gohai/dsbrut/libdsbrut/doc/dsbrut_midi.jpg

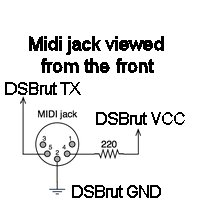
libdsbrut/doc/dsbrut_midi.jpg
