gohai/dsbrut/pcb/ds_bluetooth_v2.png

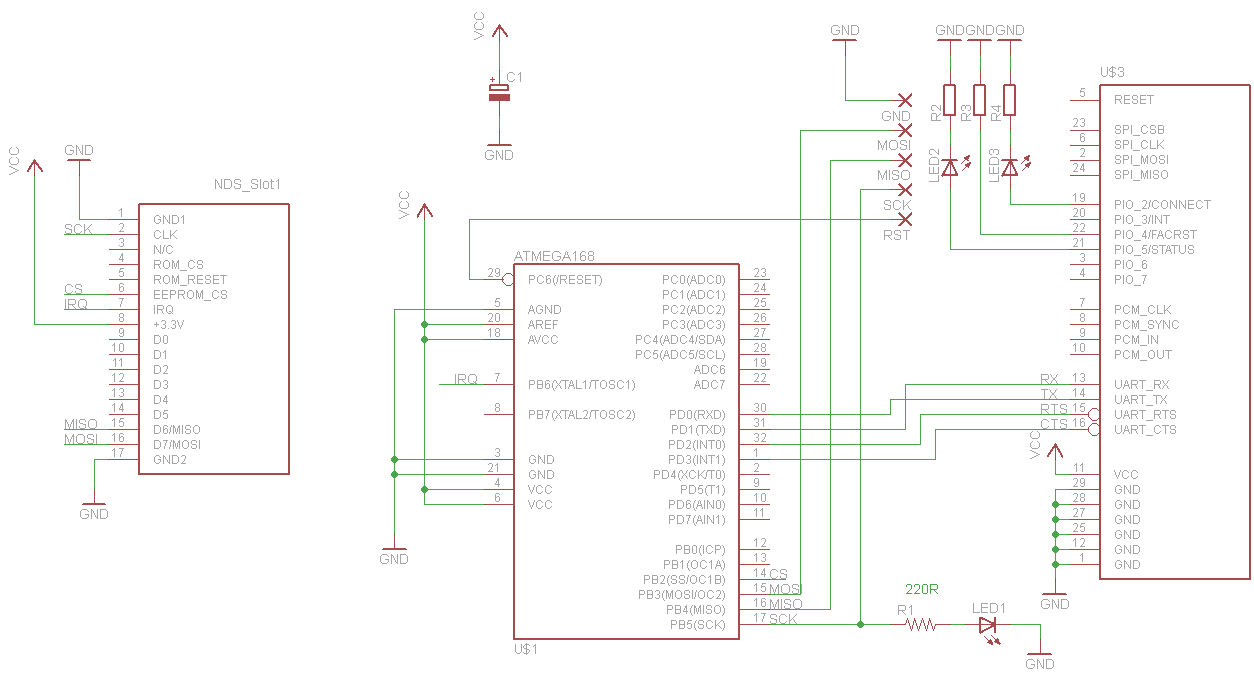
pcb/ds_bluetooth_v2.png
