gohai/dsbrut/pcb/dsbrut2.brd

## EAGLE design pcb/dsbrut2.brd (2014-06-26)

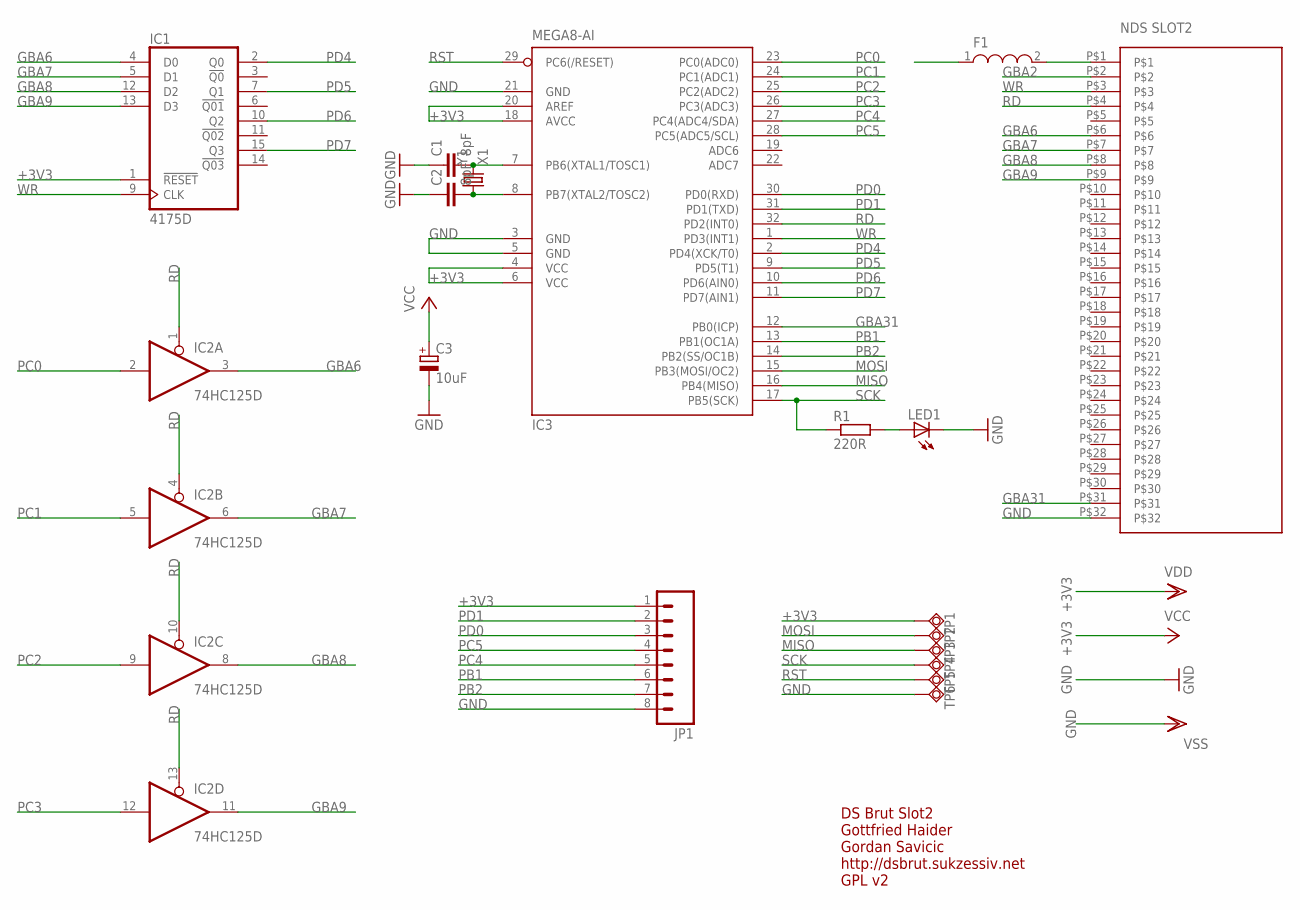
[picture p3: schematic dsbrut2.sch]

Parts:
C1, C2: 8pF; C0603K
C3: 10uF; SMC_A
F1: F1; L1812
IC1: 4175D; SO16
IC2: 74HC125D; SO14
IC3: MEGA8-AI; TQFP32-08
JP1: M08LONGPADS; 1X08_LONGPADS
LED1: LED0603; LED-0603
R1: 220R; M0805
TP1, TP2, TP4, TP5, TP6: TPSQTP16R; TP16R
TP3: TPSQTP16SQ; TP16SQ
U$1: DS_CARTRIDGE_SLOT2; DS-CARTRIDGE-SLOT2
Y1: X1; CRYSTAL-SMD-5X3

Connections:
+3V3: C3.+, F1.1, IC1.1 (!RESET), IC1.16 (VDD), IC2.14 (VCC), IC3.4 (VCC), IC3.6 (VCC), IC3.18 (AVCC), IC3.20 (AREF), JP1.1, TP1.TP
GBA2: U$1.P$2
GBA6: IC1.4 (D0), IC2.3 (O), U$1.P$6
GBA7: IC1.5 (D1), IC2.6 (O), U$1.P$7
GBA8: IC1.12 (D2), IC2.8 (O), U$1.P$8
GBA9: IC1.13 (D3), IC2.11 (O), U$1.P$9
GBA31: IC3.12 (PB0(ICP)), U$1.P$31
GND: C1.1, C2.1, C3.-, IC1.8 (VSS), IC2.7 (GND), IC3.3 (GND), IC3.5 (GND), IC3.21 (GND), JP1.8, LED1.C, TP6.TP, U$1.P$32
MISO: IC3.16 (PB4(MISO)), TP3.TP
MOSI: IC3.15 (PB3(MOSI/OC2)), TP2.TP
unnamed: F1.2, U$1.P$1
unnamed: C1.2, IC3.7 (PB6(XTAL1/TOSC1)), Y1.3 (2)
unnamed: LED1.A, R1.2
PB1: IC3.13 (PB1(OC1A)), JP1.6
PB2: IC3.14 (PB2(SS/OC1B)), JP1.7
PB7: C2.2, IC3.8 (PB7(XTAL2/TOSC2)), Y1.1
PC0: IC2.2 (I), IC3.23 (PC0(ADC0))
PC1: IC2.5 (I), IC3.24 (PC1(ADC1))
PC2: IC2.9 (I), IC3.25 (PC2(ADC2))
PC3: IC2.12 (I), IC3.26 (PC3(ADC3))
PC4: IC3.27 (PC4(ADC4/SDA)), JP1.5
PC5: IC3.28 (PC5(ADC5/SCL)), JP1.4
PD0: IC3.30 (PD0(RXD)), JP1.3
PD1: IC3.31 (PD1(TXD)), JP1.2
PD4: IC1.2 (Q0), IC3.2 (PD4(XCK/T0))
PD5: IC1.7 (Q1), IC3.9 (PD5(T1))
PD6: IC1.10 (Q2), IC3.10 (PD6(AIN0))
PD7: IC1.15 (Q3), IC3.11 (PD7(AIN1))
RD: IC2.1 (OE), IC2.4 (OE), IC2.10 (OE), IC2.13 (OE), IC3.32 (PD2(INT0)), U$1.P$4
RST: IC3.29 (PC6(/RESET)), TP5.TP
SCK: IC3.17 (PB5(SCK)), R1.1, TP4.TP
WR: IC1.9 (CLK), IC3.1 (PD3(INT1)), U$1.P$3

Notes on the sheet:
DS Brut Slot2 Gottfried Haider Gordan Savicic http://dsbrut.sukzessiv.net GPL v2

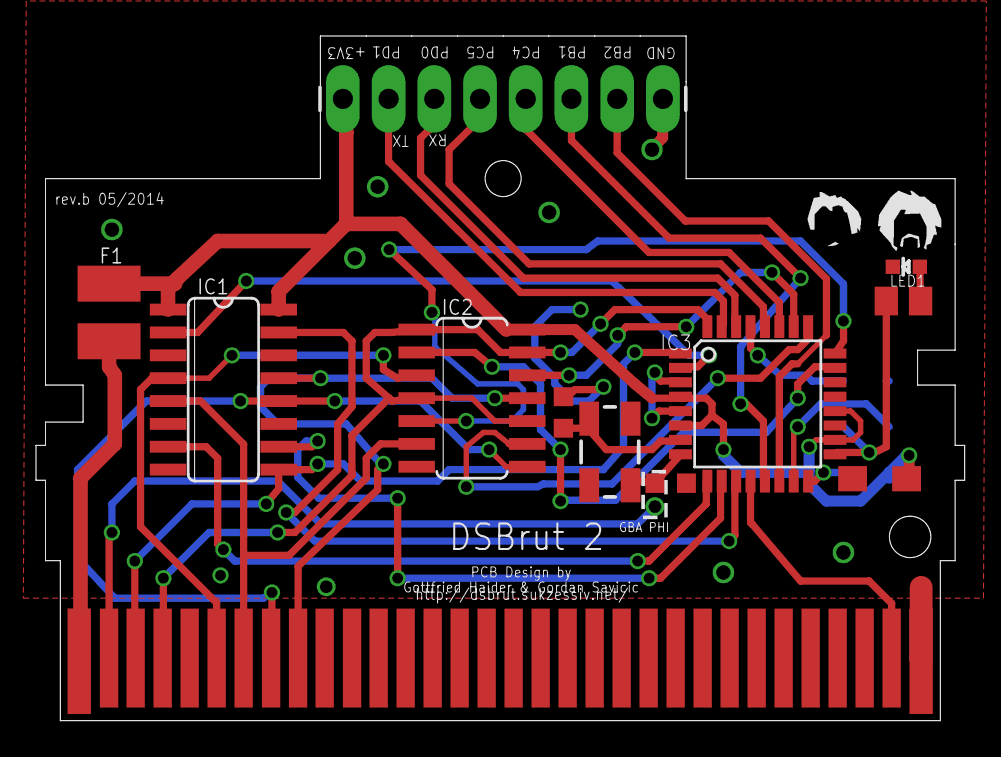
[picture p4: board dsbrut2.brd from above]

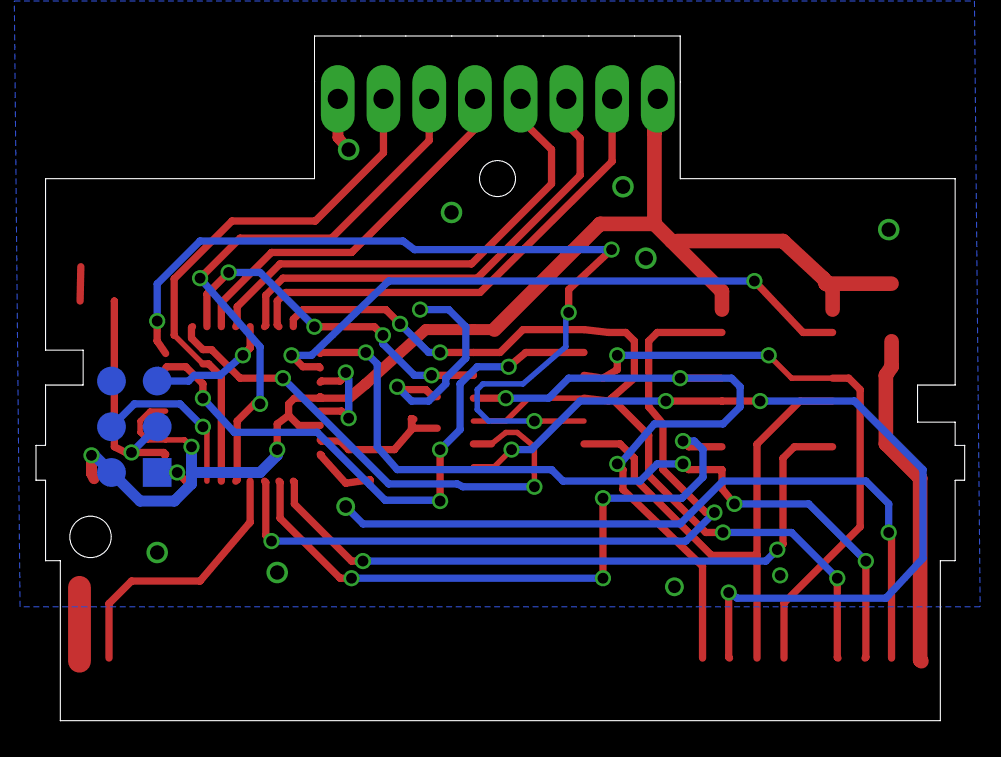
[picture p5: board dsbrut2.brd from below]

Board: 2 copper layers, 51.6 x 38.0 mm, 18 parts (6 on the bottom side), 31 nets.
