gohai/dsbrut/libdsbrut/arm9/source/brut.c

/*
 *	brut.c - DS brut, Arduino-like functions
 *
 *	Copyright Gottfried Haider & Gordan Savicic 2008-2009.
 *
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
 *	You should have received a copy of the GNU Lesser General Public License
 *	along with this program.  If not, see <http://www.gnu.org/licenses/>.
 */

#include <nds.h>
#include <string.h>
#include "brut.h"
#include "uart.h"


uint16 analog_read(uint8 pin)
{
	uint8 msg[] = { '\\', 'a', 0x00, 0x00, 0x00 };
	
	// fix pin mapping
	if (pin == PC5) {
		msg[2] = 5;
	} else if (pin == PC4) {
		msg[2] = 4;
	} else if (pin == PC3) {
		msg[2] = 3;
	} else {
		msg[2] = pin;
	}
	
	// we wait for an irq after the 3rd byte (when the adc occurs)
	// this might be a good idea for all arduino-like functions
	uart_write_prio(msg, 5, msg, 0x02);
	uart_wait_prio(2);
	
	return (msg[3]<<8)|msg[4];
}


void analog_read_fast(bool start, uint8 pin)
{
	// todo: needs more testing
	uint8 msg[] = { '\\', 'f', 0x00 };
	uint16 i;
	
	if (!start)
		msg[1] = 'F';			// stop command
	
	// fix pin mapping
	if (pin == PC5) {
		msg[2] = 5;
	} else if (pin == PC4) {
		msg[2] = 4;
	} else if (pin == PC3) {
		msg[2] = 3;
	} else {
		msg[2] = pin;
	}
	
	if (start) {
		// flush output buffer first
		uart_flush();
		uart_write_prio(msg, 3, NULL, 0x00);
		uart_wait_prio(2);
		// drain the remaining in-queue with dummy reads
		while((i = uart_read(NULL, 128)));		
		// this would be the place to adjust the spi rate
	} else {
		uart_write_prio(msg, 2, NULL, 0x00);
		uart_wait_prio(2);
		// drain the remaining in-queue with dummy reads
		while((i = uart_read(NULL, 128)));
		// this would be the place to adjust the spi rate again
	}
}


void analog_write(uint8 pin, uint8 val)
{
	uint8 msg[] = { '\\', 'A', 0x00, 0x00 };
	
	msg[2] = pin;
	msg[3] = val;
	
	uart_write_prio(msg, 4, NULL, 0x00);
	uart_wait_prio(0);
}


uint8 atmega_read_8(uint8 reg)
{
	uint8 msg[] = { '\\', 'r', 0x00, 0x00 };
	
	msg[2] = reg;
	uart_write_prio(msg, 4, msg, 0x00);
	uart_wait_prio(0);
	
	return msg[3];
}


void atmega_reset(bool wait)
{
	// note: untested atm
	
	uint8 msg[] = { '\\', 'x' };
	uint8 ver;
	
	uart_write_prio(msg, 2, NULL, 0x00);
	uart_wait_prio(0);
	
	if (!wait)
		return;
	// wait for the card to be ready again
	do {
		ver = uart_firmware_ver();
		uart_wait();
	} while (ver == 0x00 || ver == 0xff);
}


void atmega_write_8(uint8 reg, uint8 val)
{
	uint8 msg[] = { '\\', 'R', 0x00, 0x00 };
	
	msg[2] = reg;
	msg[3] = val;
	uart_write_prio(msg, 4, NULL, 0x00);
	uart_wait_prio(0);
}


bool digital_read(uint8 pin)
{
	uint8 msg[] = { '\\', 'd', 0x00, 0x00 };
	
	msg[2] = pin;
	
	uart_write_prio(msg, 4, msg, 0x00);
	uart_wait_prio(0);
	
	if (msg[3] != 0x00) {
		return true;
	} else {
		return false;
	}
}


void digital_write(uint8 pin, bool val)
{
	uint8 msg[] = { '\\', 'D', 0x00, 0x00 };
	
	msg[2] = pin;
	if (val) {
		msg[3] = 0x01;
	}
	
	uart_write_prio(msg, 4, NULL, 0x00);
	uart_wait_prio(0);
}


uint8 i2c_receive(uint8 addr, uint8 *dest, uint8 size)
{
	// note: untested atm
	
	uint8 *msg = (uint8*)malloc(5+size);
	uint8 ret;
	
	if (!msg) {
		return 0;		// out of memory
	}
	msg[0] = '\\';
	msg[1] = 'i';
	msg[2] = addr;
	msg[3] = size;
	// all remaining bytes are dummy bytes
	
	// we wait for an irq after the 4th byte (when the transmission 
	// occurs)
	// note: size must be < 32, otherwise we fall back to the timeout
	uart_write_prio(msg, 5+size, msg, 1<<size);
	uart_wait_prio(5);
	
	// actual payload size is returned in the first byte
	if (msg[4] > size) {
		// invalid payload size
		free(msg);
		return 0;		// invalid size returned
	}
	
	// copy to destination buffer
	memcpy(dest, msg+5, msg[4]);
	
	ret = msg[4];
	free(msg);
	return ret;
}


uint8 i2c_send(uint8 addr, const uint8* src, uint8 size)
{
	// note: untested atm
	
	uint8 *msg = (uint8*)malloc(4+size+1);
	uint8 ret;
	
	if (!msg) {
		return 0xff;	// out of memory
	}
	msg[0] = '\\';
	msg[1] = 'I';
	msg[2] = addr;
	msg[3] = size;
	memcpy(msg+4, src, size);
	// final byte is for reading the result
	
	// we wait for an irq on the final byte (when the transmission occurs)
	uart_write_prio(msg, 4+size+1, msg, 0x01);
	uart_wait_prio(5);
	
	ret = msg[4+size];
	free(msg);
	return ret;			// return result
}


void servo_detach(uint8 pin)
{
	uint8 msg[] = { '\\', 's', 0x00 };
	
	msg[2] = pin;
	uart_write_prio(msg, 3, NULL, 0);
	uart_wait_prio(0);
}


bool servo_set(uint8 pin, uint8 pos)
{
	uint8 msg[] = { '\\', 'S', 0x00, 0x00, 0x00 };
	
	msg[2] = pin;
	msg[3] = pos;
	// last byte is for return value
	uart_write_prio(msg, 5, msg, 0x00);
	uart_wait_prio(0);
	
	if (msg[4]) {
		return true;
	} else {
		return false;
	}
}


bool em4102_send(uint8 pin, const uint8* data, uint8 tries)
{
	uint8 msg[] = { '\\', 'E', 0x00, 0x00, 0x00, 0x00, 0x00, 0x00, 0x00, 0x00 };
	
	msg[2] = pin;
	msg[3] = tries;
	msg[4] = data[0];
	msg[5] = data[1];
	msg[6] = data[2];
	msg[7] = data[3];
	msg[8] = data[4];
	
	// we wait for an irq on the final byte (when the transmission occurs)
	uart_write_prio(msg, 10, NULL, 0x01);
	if (uart_wait_prio(5))
		return true;
	else
		return false;
}
