gohai/dsbrut/(commit log)

2008-10-09 initial import
    [ds_atmega168.brd, ds_atmega168.sch, ds_gig_master.brd, ds_gig_master.sch, ds_gig_slave.brd, ds_gig_slave.sch]
2008-10-20 libdsuart-0.2 + added uartI2CSend(), uartI2CReceive() + Card Line interrupt functionality
2008-11-16 changed uartOpen() to wait for cartridge to become accessible (prevents bogus readings right after bootup) changed variable type to the more common {u,}int{8,16,32} fixed a bug in main.c that ate eve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
    [main.c, uart.c, uart.h]
2009-03-26 import libdsbrut 0.9 (complete rewrite)
    [ds_atmega168.brd, ds_atmega168.sch, ds_gig_master.brd, ds_gig_master.sch, ds_gig_slave.brd, ds_gig_slave.sch]
2009-04-05 started implementing bill's fast adc code
2009-04-06 made a function for bill's fast adc code (untested, still) more changes to the firmware made uart_read() handle dummy reads (dest is NULL)
2009-04-08 add more fast adc related documentation
2009-08-20 fix analog_read(), analog_read_fast() on custom pins (makes reading the 3g sensor work) cleanup atmega sketch a bit copy new libdsbrut revision to projects compile sources using latest devkitPro (lib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
    [brut.c, brut.h, uart.c]
2009-09-08 add ds bluetooth code add some bluetooth testing code to term fixed uart_readln() fixed uart_requeue() updated term_scsd binary (for supercard sd lite) changed tab width (to 8 characters) minor docum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
    [brut.h, bt.c, bt.h, main.c, uart.c, uart.h]
2009-09-18 add a function for setting the parity on the uart device add a function for block-like writing the content of a buffer over the uart device update firmware sketch
2009-10-04 make libdsbrut also work on arm7 this needs a time7.h as time() seems to be broken on arm7 make uart_write_block() not allocate memory on the fly update project binaries
    [time7.h, uart.c, uart.h]
2010-04-11 add em4102 test code (needs latest firmware) fix compile warning
    [brut.c, brut.h, bt.c, main.c]
2010-04-14 fix a typo in em4102 checksum generation add documentation
    [brut.c, brut.h, main.c]
2010-05-07 add support for controlling up to 4 servos rebuild everything with latest devkitpro and arduino 0018
2014-05-17 Start Slot-2 development
2014-05-21 schematic/board first draft
    [dsbrut2.brd, dsbrut2.sch]
2014-05-21 updated isp progheader - please verify orientation
    [dsbrut2.brd, dsbrut2.sch]
2014-05-22 added rst, sck led, aref vcc, cleanup
    [dsbrut2.brd, dsbrut2.sch]
2014-05-23 Add GBA{8,9} and connections between IC{1,2} and the AtMega
    [dsbrut2.brd, dsbrut2.sch]
2014-05-23 Add a variant with only a two bit data bus for discussion
    [dsbrut2_2bit.brd, dsbrut2_2bit.sch]
2014-05-26 from 2to4to2 layers - added gba4/5/6/7/8 etc...
    [dsbrut2.brd]
2014-05-27 Connected RD to ATmega, added TX/RX labels, removed ground plane underneath Slot -2 pins
    [dsbrut2.brd, dsbrut2.sch]
2014-05-27 added fuse, fixed ic1 power supply with VSS
    [dsbrut2.brd, dsbrut2.sch]
2014-05-27 Changed fuse label, moved a via, minor trace beautification
    [dsbrut2.brd, dsbrut2.sch]
2014-05-27 power supply pin 16 on ic1
    [dsbrut2.brd, dsbrut2.sch]
2014-05-27 Made pin1 of the ICSP connector square
    [dsbrut2.brd, dsbrut2.sch]
2014-05-28 added crystal, jumper bridge for gba2
    [dsbrut2.brd, dsbrut2.sch]
2014-05-28 cleanup, added our two faces on silkscreen layer
    [dsbrut2.brd, dsbrut2.sch]
2014-05-28 added c3 between vcc and gnd, moved c2 away from steg
    [dsbrut2.brd, dsbrut2.sch]
2014-05-29 Renamed GBA PHI, added label to F1, moved GBA PHI solder bridge slightly, moved some labels slightly
    [dsbrut2.brd]
2014-05-29 solder bridge drc
    [dsbrut2.brd]
2014-05-29 Label Xtal caps as 18uF, moving a few labels
    [dsbrut2.brd, dsbrut2.sch]
2014-05-29 Changed 18pF to 8pF, labeled C3 as 10uF
    [dsbrut2.brd, dsbrut2.sch]
2014-05-29 changed soldermask of gba2 bridge, added gerber files, added CAM file for dsbrut2, zip file for order in sexy bash script
    [dsbrut2.GBL, dsbrut2.GBO, dsbrut2.GBP, dsbrut2.GBS, dsbrut2.GTL, dsbrut2.GTO, dsbrut2.GTP, dsbrut2.GTS]
2014-06-01 Add gerber files for rev. a
2014-06-01 Added prelim. bill of materials for rev. a
2014-06-26 Switch from ATMega 328 to 328P
2014-06-26 Swap ICSP pads on the bottom, add some keepouts
    [dsbrut2.brd]
2014-07-13 Update BOM
2015-03-07 Make firmware compile with recent versions of Arduino
2015-12-30 Port libspi to current devKitPro
2015-12-30 Fix printf warnings
