gohai/dsbrut/(notices)

Notices in the files:
libdsbrut/arm9/source/main.c:
it under the terms of the GNU Lesser General Public License as published by
the Free Software Foundation, either version 3 of the License, or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
parts and their libraries:
SparkFun-Connectors: Licensing: Creative Commons ShareAlike 4.0 International - https://creativecommons.org/licenses/by-sa/4.0
